arthurdommange-cell/drone-vtol/rapports de séance/Petanky SEKONGO/README.md

# Rapports de séance de Petanky SEKONGO

Un fichier par séance, nommé avec le numéro de la séance puis le nom : `1_SEKONGO_Petanky.md`, `2_SEKONGO_Petanky.md`, etc.
