arthurdommange-cell/drone-vtol/(commit log)

2026-11-06 Rapport de séance S1 (Arthur DOMMANGE)
2026-11-06 Rapport S1 finalisé (inventaire et CAO de la nacelle)
2026-11-06 Rangement : rapport de séance 1 dans le dossier d'Arthur
2026-11-06 Rangement : dossier des rapports de séance de Petanky
2026-11-06 Rangement : suppression de l'ancien emplacement du rapport S1
2026-11-07 Rapport S1 : les engrenages font partie du rapport (2 reçus sur 6)
2026-11-07 Rapport de séance 1 (PDF et Word)
2026-11-07 Rapport de séance 1 : version Markdown remplacée par le PDF
2026-11-07 Ajoute le rapport de séance 1 de Mamadou
2026-11-11 Rapport de séance 2 (PDF et Word)
2026-11-11 Ajout des programmes Arduino et Python
2026-11-11 Ajout du rapport de la seance 2
